smhong1514/rram-xor-inference/analog/pic/pic/sense_amp_ex.png

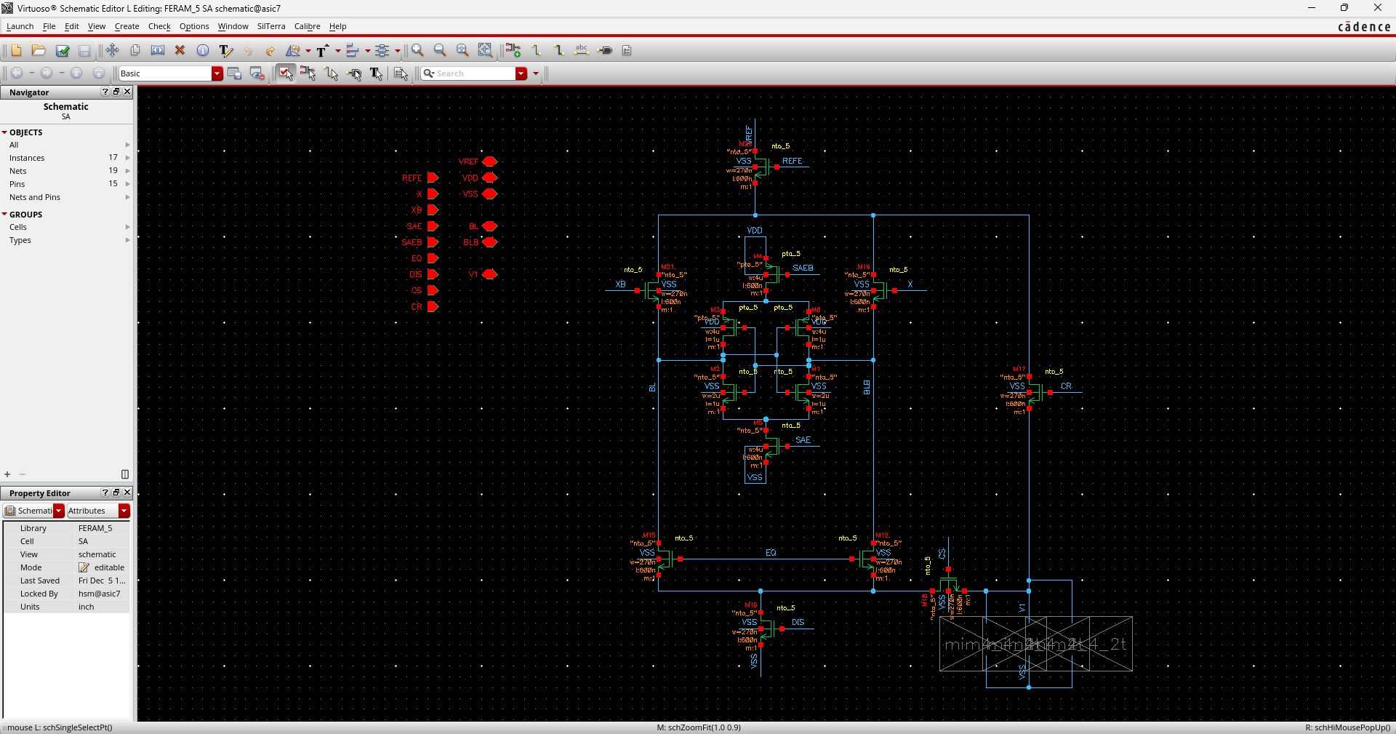
analog/pic/pic/sense_amp_ex.png
