smhong1514/rram-xor-inference/analog/pic/pic/sense_amp_v1.png

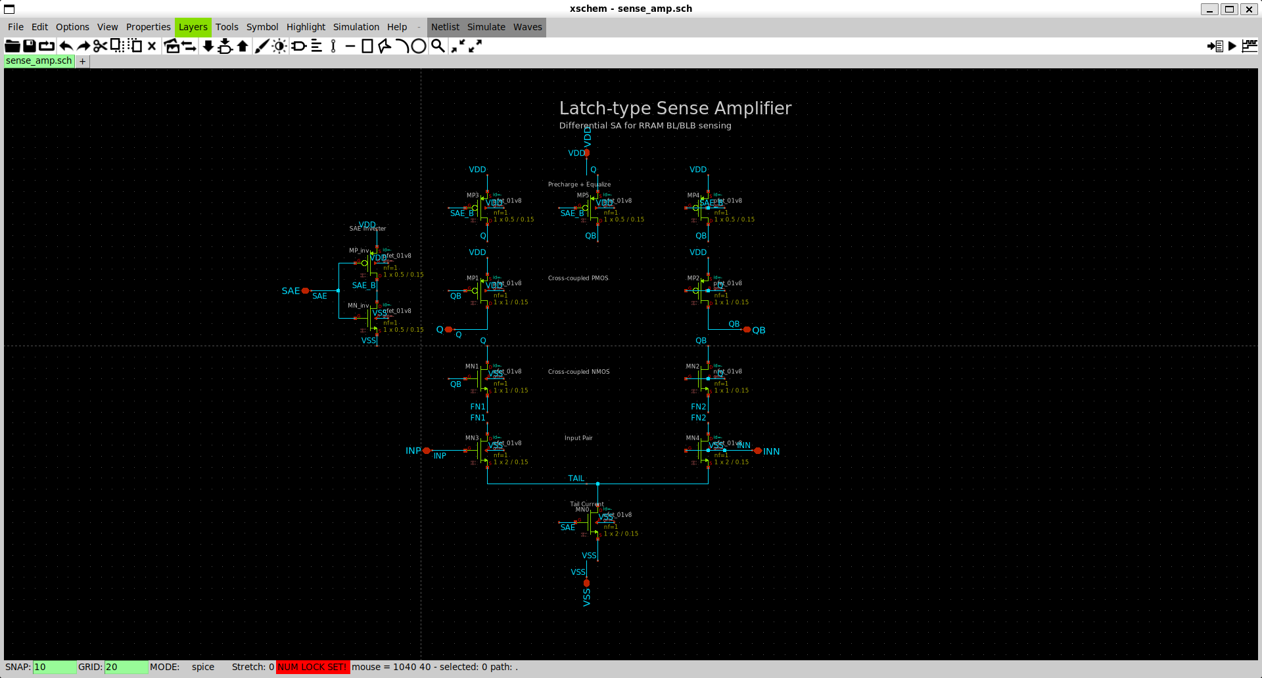
analog/pic/pic/sense_amp_v1.png
