smhong1514/rram-xor-inference/analog/pic/pic/sense_amp_v2.png

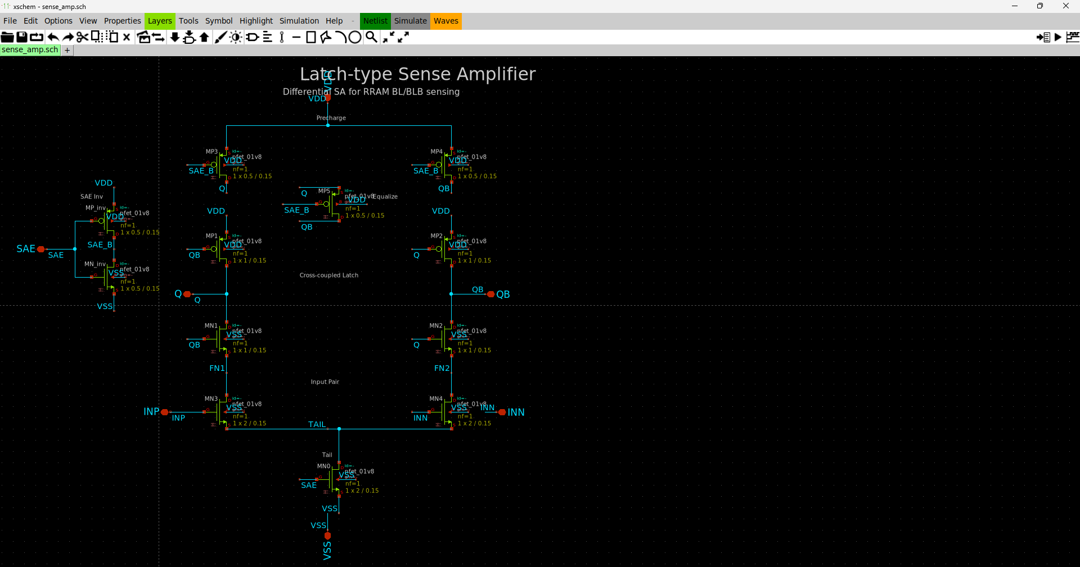
analog/pic/pic/sense_amp_v2.png
