smhong1514/rram-xor-inference/analog/pic/pic/sense_amp_v3.png

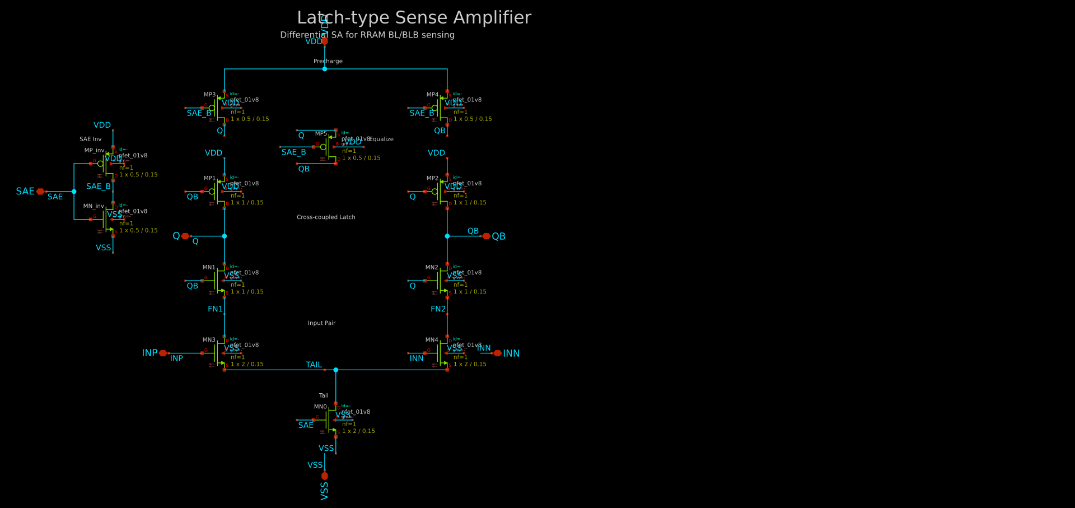
analog/pic/pic/sense_amp_v3.png
