smhong1514/rram-xor-inference/analog/pic/pic/sense_amp_v4.png

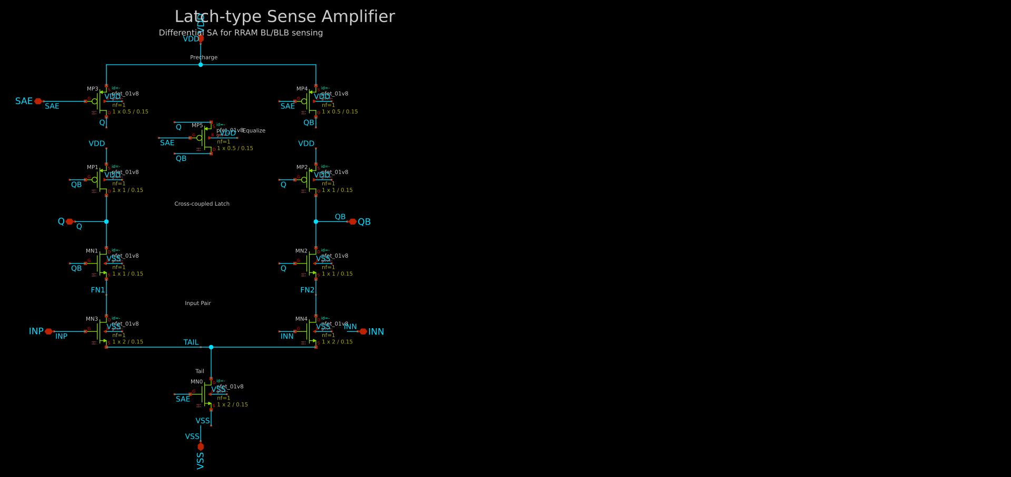
analog/pic/pic/sense_amp_v4.png
