smhong1514/rram-xor-inference/analog/pic/pic/WL_v1.png

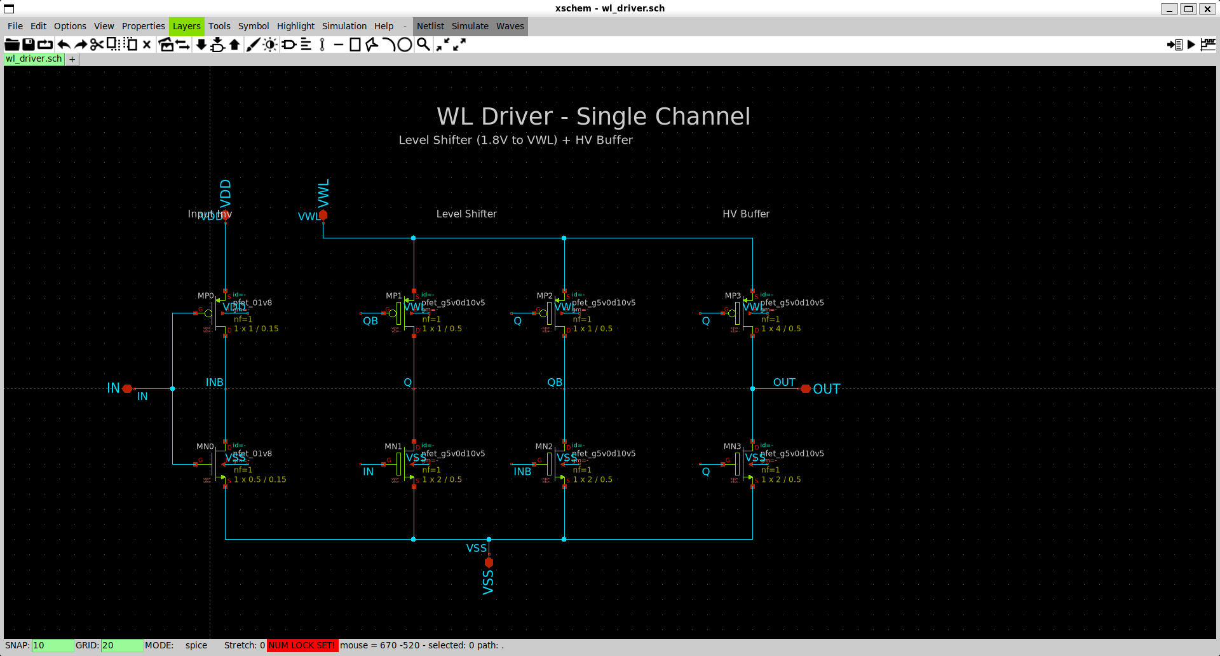
analog/pic/pic/WL_v1.png
