smhong1514/rram-xor-inference/analog/sim/postlayout/blwd_compare.png

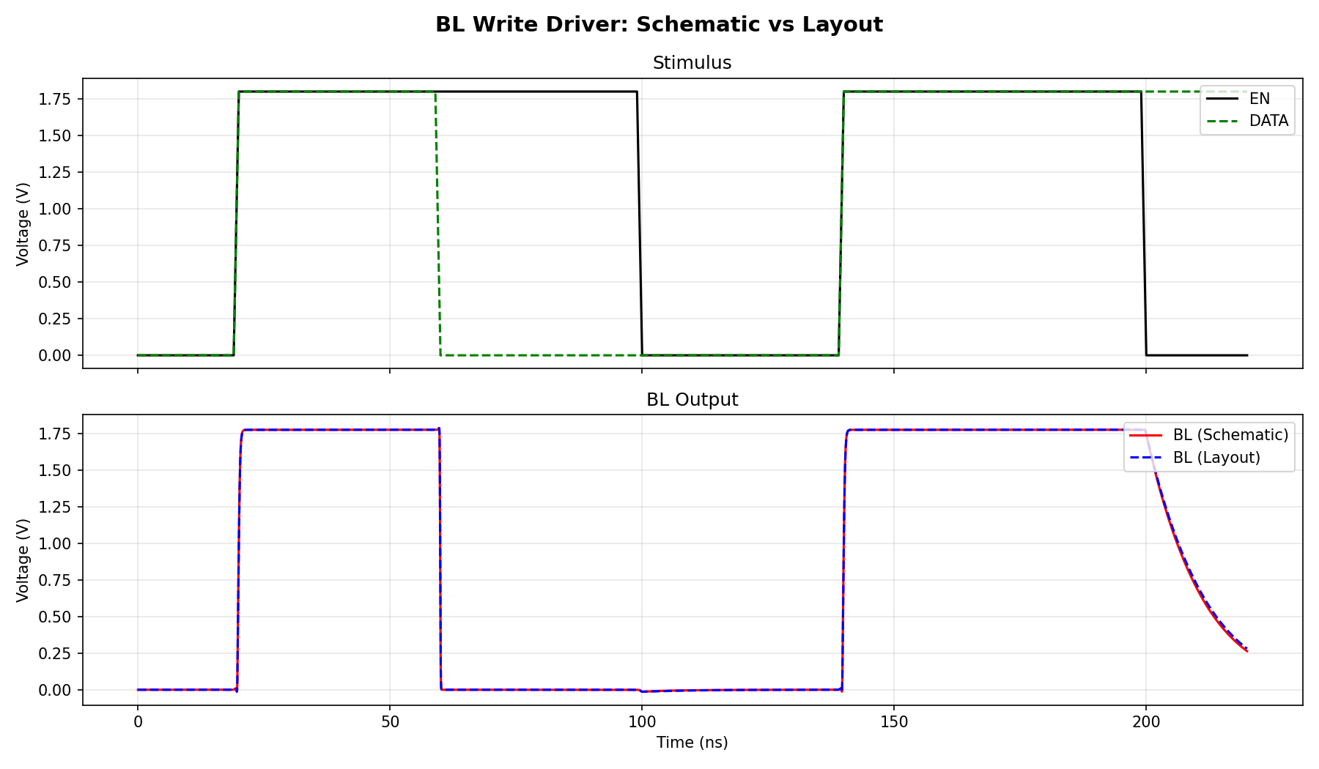
analog/sim/postlayout/blwd_compare.png
