smhong1514/rram-xor-inference/analog/sim/postlayout/sa_compare.png

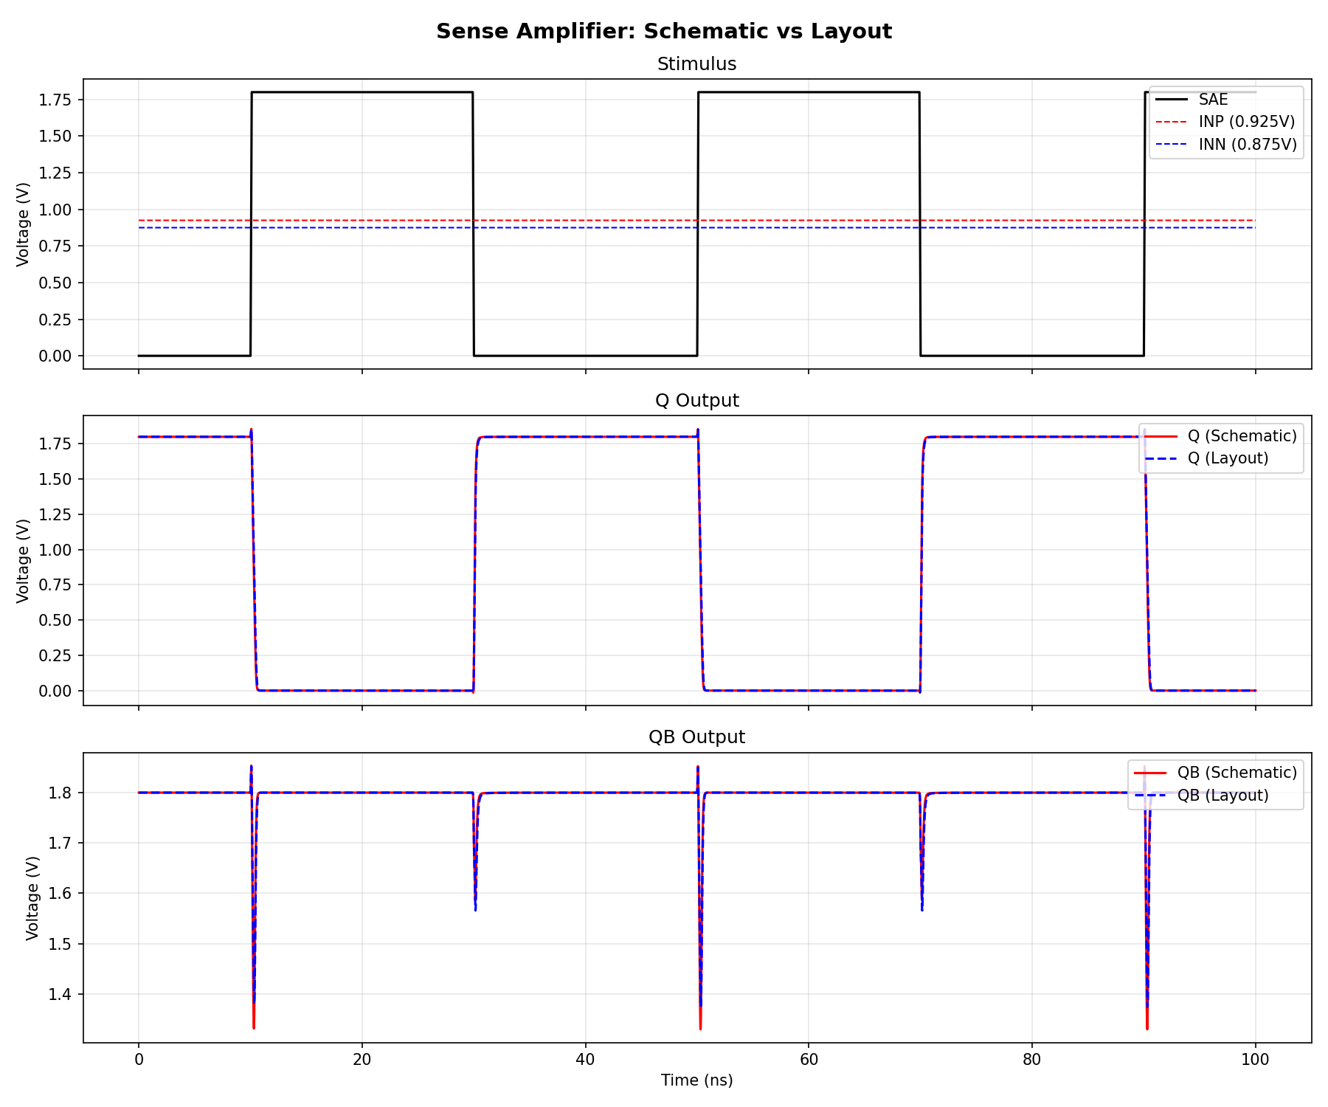
analog/sim/postlayout/sa_compare.png
