smhong1514/rram-xor-inference/analog/sim/postlayout/wl_compare.png

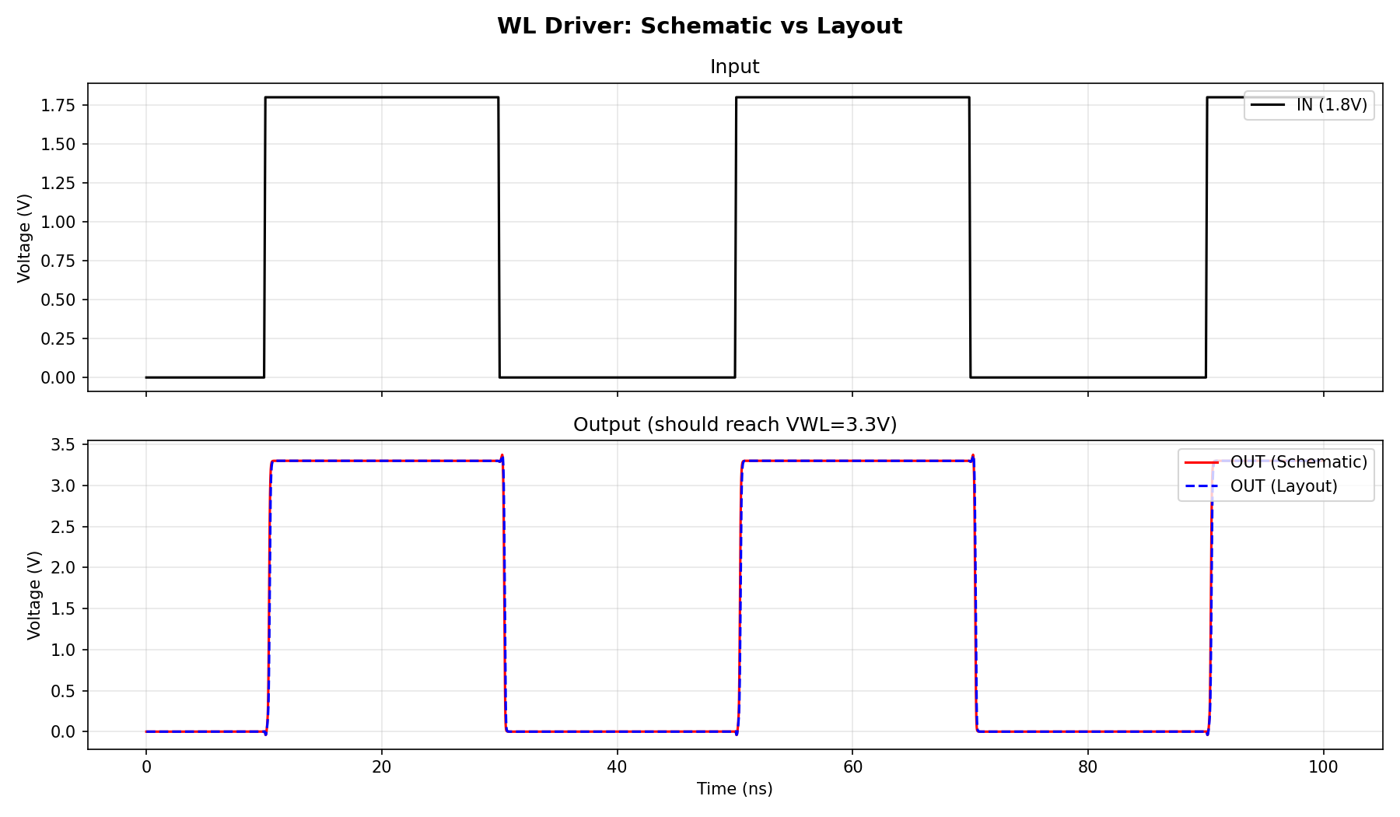
analog/sim/postlayout/wl_compare.png
