smhong1514/rram-xor-inference/analog/sim/sense_amp_sim.png

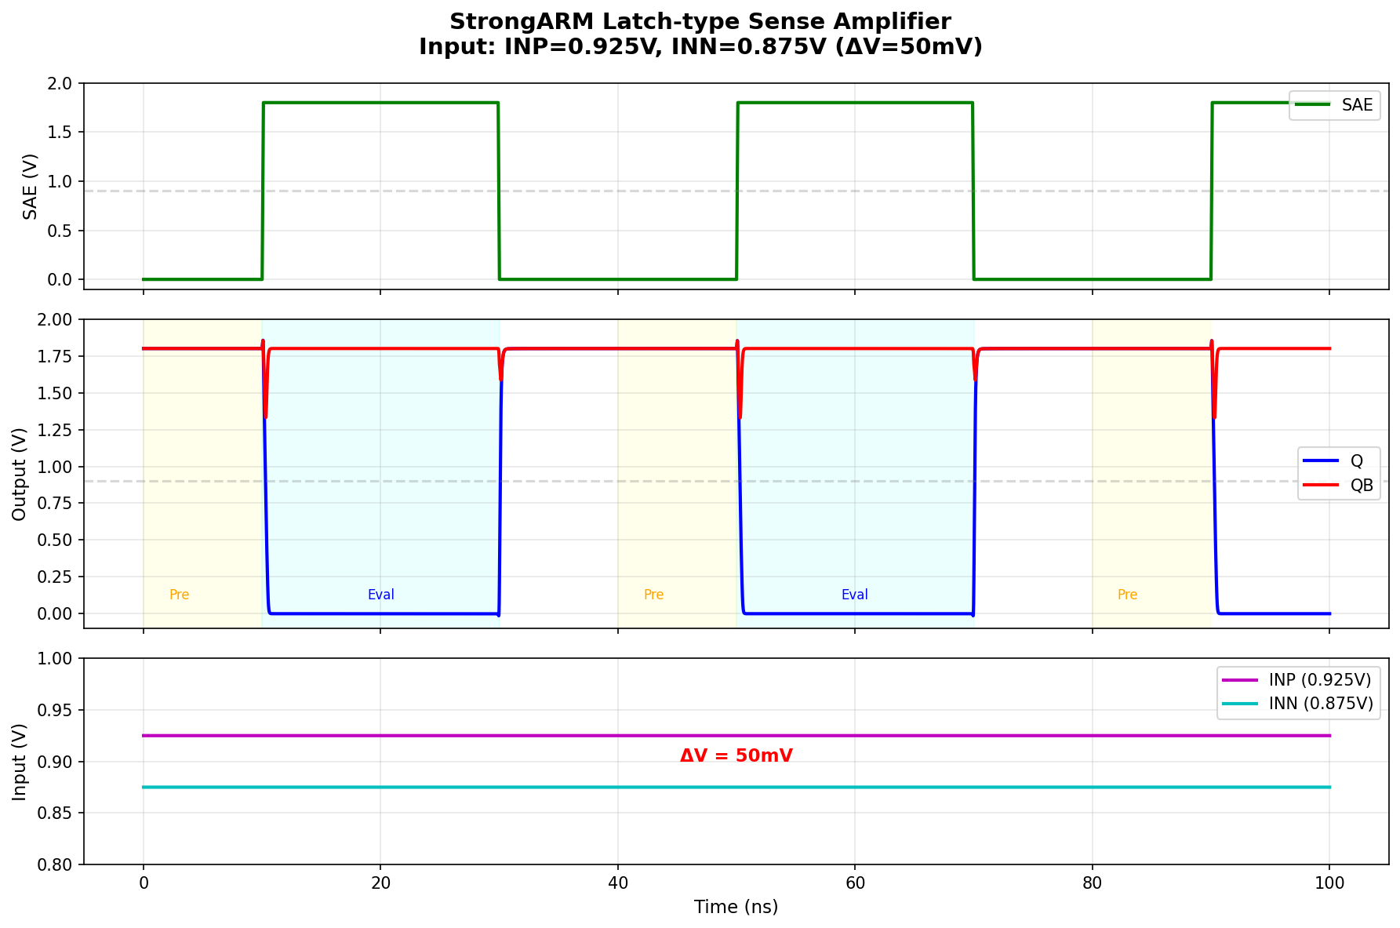
analog/sim/sense_amp_sim.png
