smhong1514/rram-xor-inference/analog/sim/xor_inference_sim.png

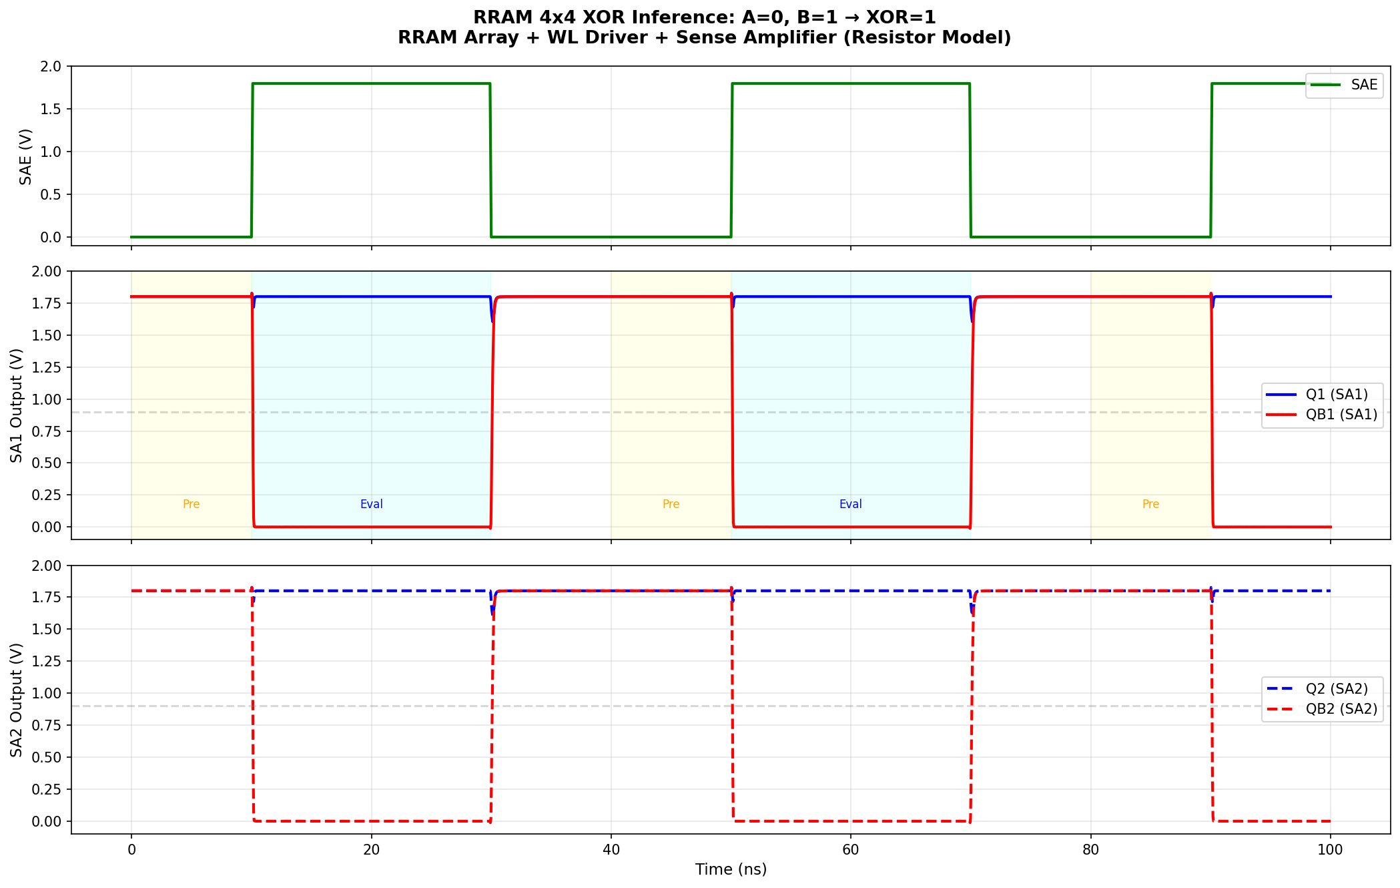
analog/sim/xor_inference_sim.png
