smhong1514/rram-xor-inference/analog/sim/cosim/rram_cosim_result.png

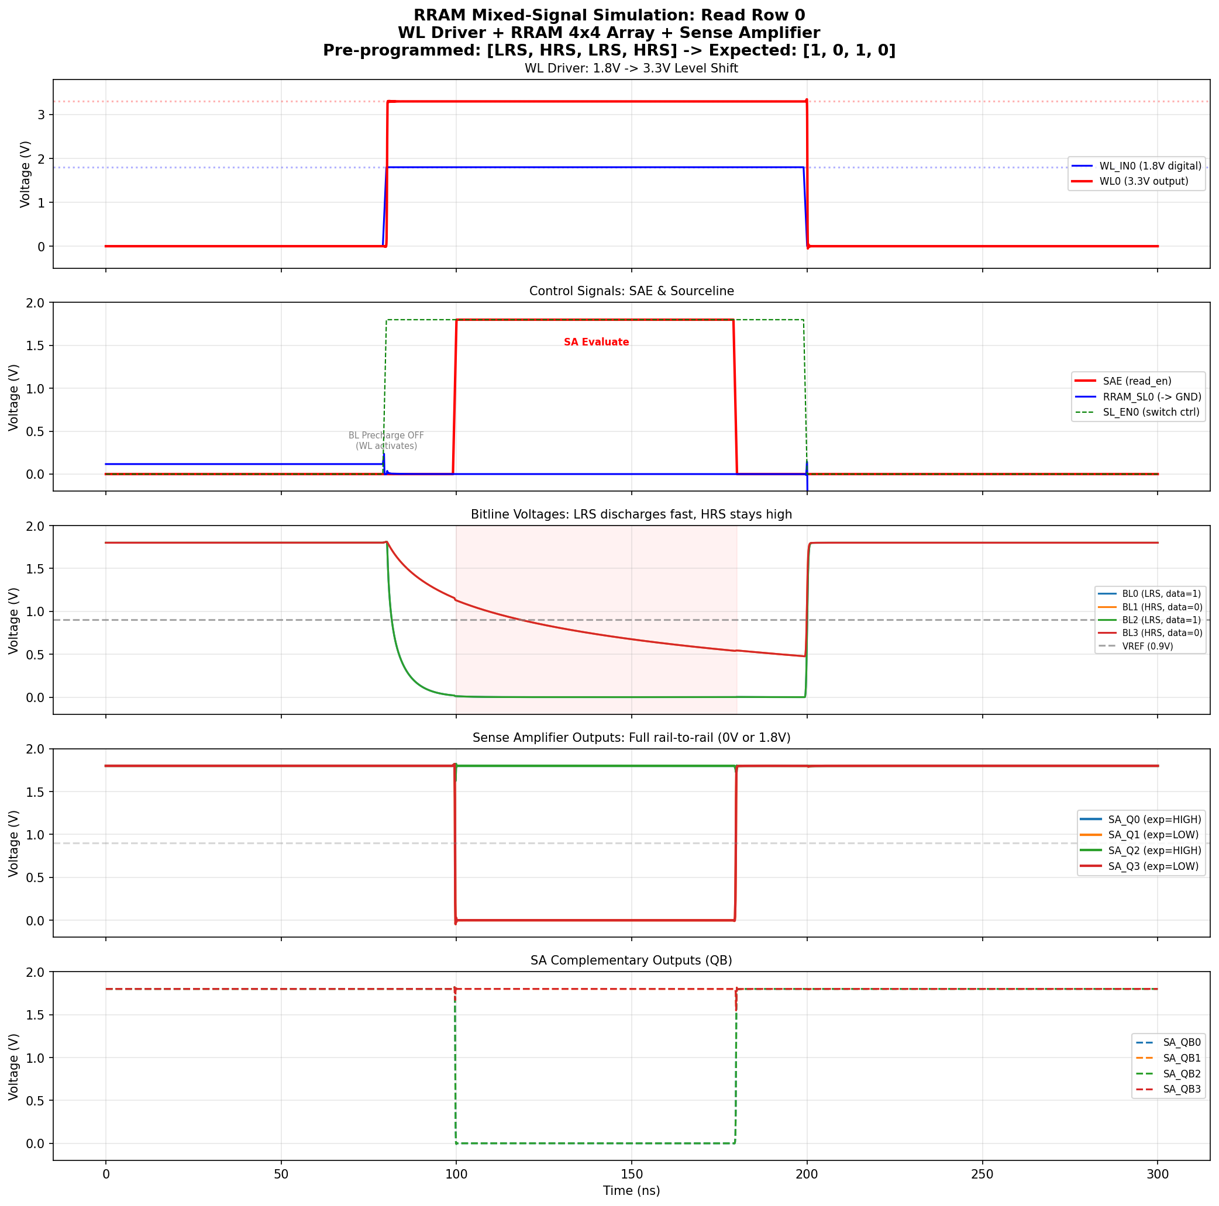
analog/sim/cosim/rram_cosim_result.png
