smhong1514/rram-xor-inference/analog/layout/sense_amp/sense_amp_flat.spice

* NGSPICE file created from sense_amp_flat.ext - technology: sky130B

.subckt sense_amp_flat SAE INP INN Q QB VDD VSS
X0 Q SAE VDD VDD sky130_fd_pr__pfet_01v8 ad=0.145 pd=1.58 as=0.145 ps=1.58 w=0.5 l=0.15
X1 QB SAE VDD VDD sky130_fd_pr__pfet_01v8 ad=0.145 pd=1.58 as=0.145 ps=1.58 w=0.5 l=0.15
X2 dev_nfet_w200_2.D INN dev_nfet_w200_1.S VSS sky130_fd_pr__nfet_01v8 ad=0.58 pd=4.58 as=0.58 ps=4.58 w=2 l=0.15
X3 Q QB dev_nfet_w200_0.S VSS sky130_fd_pr__nfet_01v8 ad=0.29 pd=2.58 as=0.29 ps=2.58 w=1 l=0.15
X4 dev_nfet_w200_2.D INP dev_nfet_w200_0.S VSS sky130_fd_pr__nfet_01v8 ad=0.58 pd=4.58 as=0.58 ps=4.58 w=2 l=0.15
X5 QB SAE Q VDD sky130_fd_pr__pfet_01v8 ad=0.145 pd=1.58 as=0.145 ps=1.58 w=0.5 l=0.15
X6 dev_nfet_w200_2.D SAE VSS VSS sky130_fd_pr__nfet_01v8 ad=0.58 pd=4.58 as=0.58 ps=4.58 w=2 l=0.15
X7 Q QB VDD VDD sky130_fd_pr__pfet_01v8 ad=0.29 pd=2.58 as=0.29 ps=2.58 w=1 l=0.15
X8 QB Q VDD VDD sky130_fd_pr__pfet_01v8 ad=0.29 pd=2.58 as=0.29 ps=2.58 w=1 l=0.15
X9 QB Q dev_nfet_w200_1.S VSS sky130_fd_pr__nfet_01v8 ad=0.29 pd=2.58 as=0.29 ps=2.58 w=1 l=0.15
.ends
