smhong1514/rram-xor-inference/analog/layout/sense_amp/sense_amp_sch.spice

.subckt sense_amp SAE INP INN Q QB VDD VSS
XMP3 Q SAE VDD VDD sky130_fd_pr__pfet_01v8 L=0.15 W=0.5 nf=1
XMP4 QB SAE VDD VDD sky130_fd_pr__pfet_01v8 L=0.15 W=0.5 nf=1
XMP5 QB SAE Q VDD sky130_fd_pr__pfet_01v8 L=0.15 W=0.5 nf=1
XMP1 Q QB VDD VDD sky130_fd_pr__pfet_01v8 L=0.15 W=1 nf=1
XMP2 QB Q VDD VDD sky130_fd_pr__pfet_01v8 L=0.15 W=1 nf=1
XMN1 Q QB FN1 VSS sky130_fd_pr__nfet_01v8 L=0.15 W=1 nf=1
XMN2 QB Q FN2 VSS sky130_fd_pr__nfet_01v8 L=0.15 W=1 nf=1
XMN3 FN1 INP TAIL VSS sky130_fd_pr__nfet_01v8 L=0.15 W=2 nf=1
XMN4 FN2 INN TAIL VSS sky130_fd_pr__nfet_01v8 L=0.15 W=2 nf=1
XMN0 TAIL SAE VSS VSS sky130_fd_pr__nfet_01v8 L=0.15 W=2 nf=1
.ends
