smhong1514/rram-xor-inference/analog/layout/wl_driver/wl_driver_sch.spice

.subckt wl_driver IN OUT VDD VWL VSS
XMP0 INB IN VDD VDD sky130_fd_pr__pfet_01v8 L=0.15 W=1 nf=1
XMN0 INB IN VSS VSS sky130_fd_pr__nfet_01v8 L=0.15 W=0.5 nf=1
XMP1 Q QB VWL VWL sky130_fd_pr__pfet_g5v0d10v5 L=0.5 W=1 nf=1
XMN1 Q IN VSS VSS sky130_fd_pr__nfet_g5v0d10v5 L=0.5 W=2 nf=1
XMP2 QB Q VWL VWL sky130_fd_pr__pfet_g5v0d10v5 L=0.5 W=1 nf=1
XMN2 QB INB VSS VSS sky130_fd_pr__nfet_g5v0d10v5 L=0.5 W=2 nf=1
XMP3 OUT Q VWL VWL sky130_fd_pr__pfet_g5v0d10v5 L=0.5 W=4 nf=1
XMN3 OUT Q VSS VSS sky130_fd_pr__nfet_g5v0d10v5 L=0.5 W=2 nf=1
.ends
