smhong1514/rram-xor-inference/(commit log)

2026-02-20 Initial commit: portable RRAM XOR inference project
    Portable version of rram_openlane with:
    - Environment setup scripts (PDK, ngspice-43, system deps)
    - All hardcoded /home/hsm/ paths replaced with env variables
    - verilator_shim.cpp 4-bug patch for d_cosim
    - OpenLane Docker tag pinned to v1.1.1
    - Python requirements.txt added
    Source: https://github.com/smhong1514/rram_openlane
    [bl_write_driver.sch, macro_placement.cfg, sense_amp.sch, sense_amp_me_v1.sch, wl_driver.sch]
2026-02-26 feat: Update to v3 — Analog ReLU Activation
    v3 replaces binary SA activation (Layer 1) with analog ReLU (5T OTA + CMOS buffer).
    OpenLane result: DRC=0, LVS=0, Timing clean (RUN_2026.02.23_18.03.08)
    Co-simulation: 4/4 XOR PASS (schematic + post-layout PEX)
    Changes:
    - RTL: xor_controller.v, input_encoder.v, rram_ctrl_top.v updated to v3
    - Phase 0: BL1 → ReLU → SL2 (analog path, no digital latch)
    - Phase 1: Array 2 WLs ON, SA2 only (2 outputs, redundant)
    - New macro: relu (5T OTA comparator + CMOS buffer, 3.04x10.86 um)
    - analog/layout/relu/ : GDS, LEF, LIB, MAG, SPICE (LVS=0)
    - analog/xschem/xschem/relu.sch : schematic
    - openlane/{gds,lef,lib}/relu.* : OpenLane integration fil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
    [macro_placement.cfg, relu.sch]
